pkottenbreit/cs207/PXL_20201113_060722639.jpg

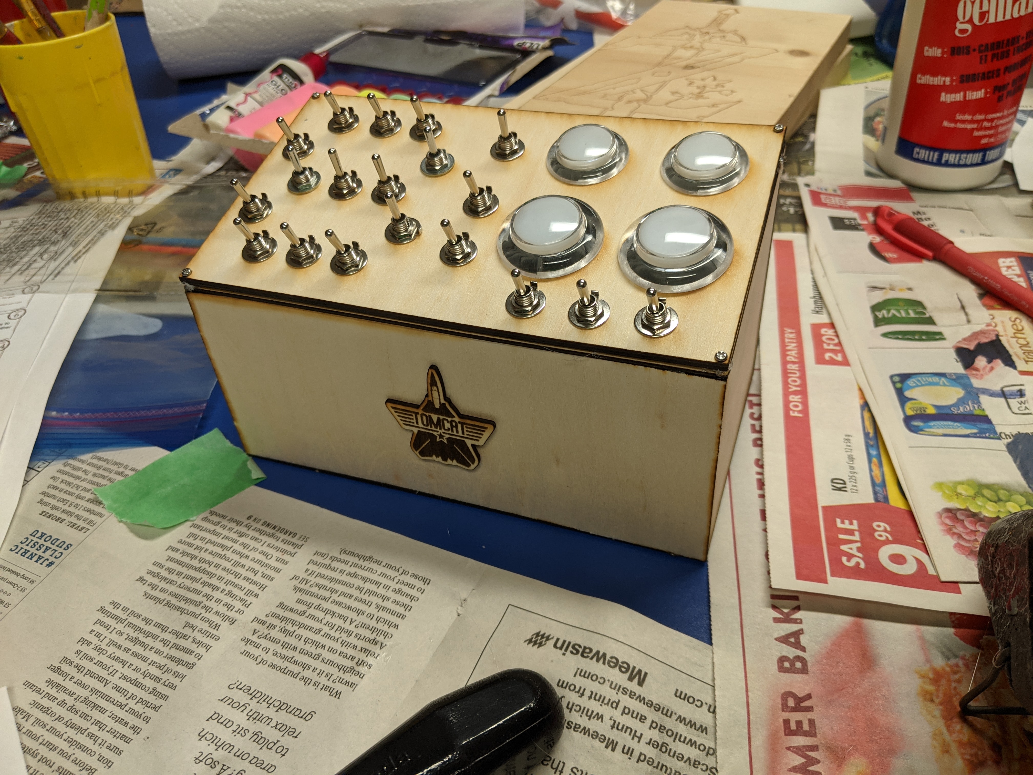
PXL_20201113_060722639.jpg
