pkottenbreit/cs207/PXL_20201125_211730181.jpg

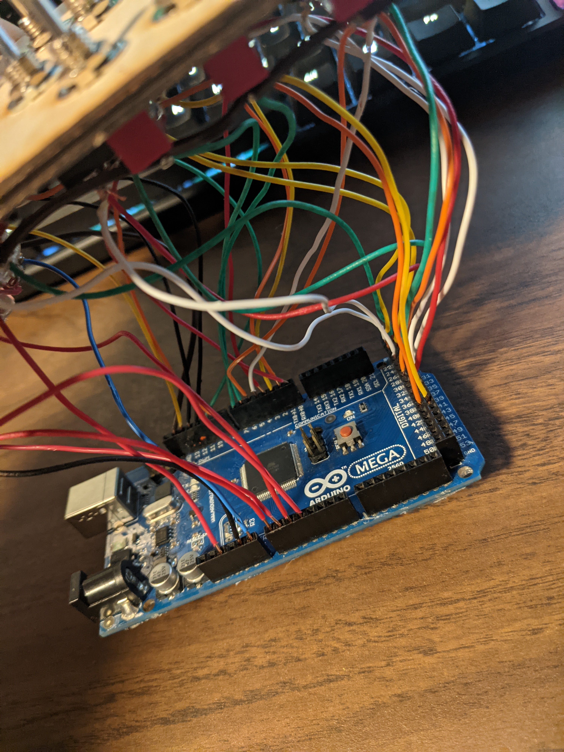
PXL_20201125_211730181.jpg
